L1m0n/night-lamp/docs/spec.md

# Приліжкова лампа — спека v1

Дата: 2026-11-01. Джерело форми: `Lamp-v0.0.2.step` — надрукований прототип 175 мм. (Перша версія спеки помилково брала `lamp-export-1.step`, 250 мм.)

## 1. Навіщо

Акумуляторна лампа на тумбочку: м'яке тепле світло перед сном, яке не будить партнера і яким легко керувати наосліп. Великий диск-дімер зверху: поворот змінює яскравість, увімкнення залежить від варіанта (див. §5). Усередині стоїть колона з адресною RGBW-стрічкою на ESP32. З телефона можна вибирати режими і пресети кольорів, а також створювати свої.

## 2. Що на виході цього етапу

1. `parts.html` — таблиця комплектуючих з чекбоксами «є / замовлено» (стан зберігається в браузері).
2. `parts-3d.html` — перегляд 3D кожної деталі окремо, з вибором деталі зі списку.
3. `render.html` — гарний рендер усієї лампи (світиться, можна крутити, є розібраний вигляд).
4. `schematic.html` — принципова схема, варіанти V1 / V2.
5. `wiring.html` — наочна схема підключень (хто куди паяється), V1 / V2.
6. `case/lamp.scad` — параметрична модель усіх друкованих деталей, і з неї STL.

**Стиль сторінок — «Папір»** (обрано з трьох варіантів): приємний, мінімалістичний.
- Тло теплий папір `#f7f4ee`, текст чорнило `#2b2722`, другорядний `#7b7266` / `#9a8f80`, лінії `#e4ddd1`.
- Один акцент — теракота `#c0643f` (позначені чекбокси, активний пункт, лінки).
- Заголовки — антиква Newsreader, текст — Inter, цифри й розміри — табличні цифри.
- Таблиці з тонкими горизонтальними лініями, без заливок і тіней; багато повітря.
- Темна тема — той самий характер на теплому темному тлі (`#1d1b18`, текст `#ece6dc`, акцент `#d9825e`).

**Не входить у цей етап:** прошивка ESP32 (буде наступним етапом, бо схема вже під неї розрахована) і креслення під фрезерування.

## 3. Форма і габарити (зі STEP)

| Тіло | Розміри |
|---|---|
| Шейдер | форма lamp-0.1.1 (`lamp-export-1.step`), зменшена ×0.7 від дна: дно-кільце r28…38.5, заокруглення R17.5, пояс Ø112 (висота 17.5–24.5 від дна), конус до Ø98 угорі, висота 164.6. Нижче шва — бетонна основа зі стінкою 5 мм, плафон 1.2 (2 лінії по 0.6). Угорі пластина 2 мм з отвором Ø20 і заглибленням Ø94.5 під дімер |
| Дімер | диск Ø93 × 2.5, знизу хвостовик Ø18 × 10 |
| Бетонна основа | одна відливка від столу (z=5) до шва (z≈48.2): зовні форма шейдера нижче шва, стінка 5 мм, порожнина з ухилом 1° до відкритого верху; на дні кишеня під IP5306 з виходом USB-C в бік +X і канал Ø8 вгору; 4 ребра 9.2×7 мм (0/90/180/270°) із замурованими латунними вставками M3×5.7 |
| Байонетне кільце | PETG, лягає в край основи зсередини, 4 гвинти M3×6 з потайною головкою в ребра; 4 Г-пази, поворот 30°. **Друкується перевернутим** (верхнім торцем на стіл): у робочому положенні його низ висить над столом на 2.4 мм через вушка; перевернуте — лише 4 малі містки ~50 мм² над головками гвинтів |
| Принтер | Bambu A1 mini, 180 × 180 × 180: найвища деталь — плафон, 137 мм; друкується догори дриґом (пластиною на стіл), підтримка в заглибленні під дімер і під пласкою полицею над манжетою (кільце ~8 мм завширшки, стінка скрізь 1.2 мм) |

Мої зміни до форми:
- **Шейдер ріжеться трохи вище поясу** на **основу** (бетон) і **плафон**: край основи на 1 мм вищий за відбивач, тож акумулятори й плати повністю в непрозорій основі. Плафон знімається байонетом у кільці.
- **Габарит після змін:** Ø112 × ~175 мм від столу (164.6 шейдер + 10 підйом) — як надрукований прототип.
- **Лампа піднята на 10 мм** над столом (було 5): під основою вміщається штекер USB-C.
- **USB-C виходить у бік основи (+X).** Модуль IP5306 лежить у кишені на дні, гніздо дивиться назовні. Кишеню і канал під дроти вгору відливаємо з надрукованим вкладишем-сердечником `puck_core`.
- **Основа — одна бетонна відливка** (корпус і ніжка разом) у друкованій формі.

### Відливання основи

Деталі форми (`mold_outer_a/b`, `mold_core`, `usb_core`) збираються в `case/stl/mold/` і в 3D-перегляд не потрапляють.

1. Підготовка: змастити воском/мастилом усі поверхні форми і штирі, віск у різьбу латунних вставок, вставки надіти на штирі сердечника.
2. Складання: половини форми стягнути болтами M3 (фланці, нижня пара + 4), поставити `puck_core` і `usb_core` (кінчик у гнізді стінки).
3. Заливка: бетон до рівня краю, повільно опустити сердечник (канал `puck_core` входить у його гніздо), прикрутити бортик M3 до фланців форми, вібрувати.
4. Розпалубка: відкрутити сердечник і підняти вгору (штирі виходять з вставок); відкрутити болти й розвести половини вздовж ±Y; виштовхнути `puck_core` униз; витягти `usb_core` убік +X.
5. Після розпалубки збити стовпчики від випусків: рівно з поверхнею на дні порожнини (там сідає шасі) і на верхах ребер (там сідають вушка кільця).
6. Друк форми: зовнішні половини зовнішньою гранню вниз, плавником вгору.

## 4. Деталі, які я проєктую

| Деталь | Матеріал | Що робить |
|---|---|---|
| Плафон (верх шейдера) | PLA білий, напівпрозорий | розсіює світло; знизу 4 ламелі байонета; угорі пластина з отвором Ø20 |
| Основа (низ шейдера) | бетон, одна відливка (+ друкована форма і сердечник `puck_core`) | вага; кишеня під IP5306 і USB-C; 4 ребра з латунними вставками M3 |
| Байонетне кільце | PETG | 4 Г-пази під ламелі плафона, горбик-фіксатор; 4 гвинти M3×6 у ребра основи |
| Форма для відливки | PLA | `mold_outer_a/b`, `mold_core`, `usb_core`; болти M3 |
| Шасі | PLA | диск у краї основи (виїмки під ребра): 4 акумулятори двома стосами по 2 з боків колони, вертикальний паз під ESP32 за їх торцем, гніздо колони в центрі |
| Колона | PLA білий | восьмигранник, грань 12.5 мм; доходить до верхньої пластини плафона (зазор 0.5), тож між колоною і плафоном вільного місця немає. Стрічка 10 мм на 8 гранях (смуга z 42.8…142.8, 6 LED); на кожній грані отвір Ø3.5 під і над смугою; угорі всередині — вузол дімера з кнопкою на поличках, ребро не дає йому провертатися; хвостовик дімера заходить у колону зверху |
| Вузол дімера V1 | PLA | гільза в колоні + каретка з потенціометром B100K, під нею кнопка KFC-003A, хід 0.4 мм |
| Вузол дімера V2 | PLA | гільза в колоні, на верхню стінку якої RK097NS кріпиться гайкою |
| Дімер | PLA/PETG пастельний | диск зі STEP; отвір у хвостовику під рифлений вал 6 мм |

## 5. Електроніка

**Живлення.** 4 × Li-Pol 850 мА·год (60×20×8 з PCM і скотчем, заміряно) **паралельно** (1S, ≈3400 мА·год) → IP5306 (заряджання через USB-C ~2 А, повна зарядка ≈2 год) → 5 В OUT → ESP32-C3 SuperMini (вхід 5V, LDO на платі) і стрічка. ESP32 від акумулятора напряму **не** живиться.

**Стрічка.** SK6812 RGBW 5 В, 60 LED/м (LT SMART, біла плата). 8 смуг по 6 LED = **48 LED** (~0.8 м). Смуги йдуть змійкою, шини 5 В/GND проходять усередині колони; дроти кожної смуги заходять у колону через отвір біля її DIN-кінця. У прошивці струм обмежено до 1.5 А (≈7.5 Вт), бо IP5306 дає максимум 2.1 А.

**Сигнал.** GPIO10 → 330 Ом → DIN, резистор впаяний у дріт біля стрічки. Зсуву рівня немає: 3.3 В нижче за поріг SK6812 (3.5 В), але зазвичай працює. Якщо стрічка мерехтить — перший світлодіод живиться через діод 1N4148 (поріг падає до ≈3 В).

**Потенціометр.** Крайні виводи на 3V3/GND, повзунок → GPIO0 (АЦП). Напруга батареї: дільник 220k/220k → GPIO1, щоб показувати заряд у веб-інтерфейсі; резистори паяються прямо на піни ESP32. Шум АЦП прибирає прошивка усередненням.

| | **V1 — твій B100K** | **V2 — RK097NS 10K з вимикачем (є, обрано)** |
|---|---|---|
| Увімкнути | натиснути дімер: каретка тисне KFC-003A → KEY на IP5306 → з'являються 5 В → ESP32 стартує | повернути зі «клацом» |
| Вимкнути | два натискання дімера за секунду — IP5306 вимикає 5 В сам. Ручка на мінімумі лише гасить світло | «клац» розриває 5 В між IP5306 і навантаженням |
| Нюанс | якщо забути вимкнути, ESP32 і погашена стрічка тягнуть ~0.1–0.15 А, акумулятор сяде за ≈ 15–20 год | IP5306 має сам прокинутись, коли знову з'являється навантаження (перевіряється на столі) |

Плати-перехідника немає: усе з'єднується дротами між модулями. R1 — у дроті DIN, R2/R3 — на пінах ESP32, кнопка V1 — прямо на KEY і GND IP5306.

**Керування з телефона (під прошивку).** Wi-Fi: точка доступу «Lamp» плюс за бажання домашня мережа, адреса `lamp.local`. Режими: теплий білий, нічник (бурштиновий, дуже тьмяний), колір, свічка, дихання, «захід сонця» з таймером вимкнення. Пресети зберігаються у флеш-пам'яті. Яскравість задає ручка.

## 6. Обмеження

- Друк FDM, стінки 2 мм (плафон 1.2), зазори 0.2–0.3 мм.
- Акумулятори перед паралельним з'єднанням вирівнюються за напругою (±0.05 В). У кожної комірки свій захист (PCM). Без захисту не з'єднувати.
- Плафон напівпрозорий, тому шасі зверху закрите білим диском-відбивачем, щоб тіні від плат не проступали.

## 7. Мої рішення (перевір)

- Восьмигранна колона і 48 LED (на грань влазить лише 6). Тіні від граней на плафоні не видно.
- ESP32 стоїть вертикально в пазу за торцем акумуляторів: лежачи вона не влазить в основу Ø112.
- Байонет, а не різьба: його простіше друкувати, і поворот лише на 30°.
- 4 акумулятори двома стосами по 2 з боків колони: 6 при стінці основи 5 мм і нинішньому шві не влазять. «Вітряк» і комірки на ребрі в торцях у Ø112 не влазять.
- Основа — бетонна відливка, а не друкована чаша: вага, і байонет не сидить у стінці 2 мм, а винесений в окреме змінне кільце на гвинтах.
- Без плати-перехідника і без зсуву рівня: три резистори в дротах. Запасний план від мерехтіння — діод 1N4148.
- Сторінки локальні; за бажання опублікую їх як посилання.

## 8. Налаштувати після пробного друку

У `case/lamp.scad` ці параметри номінальні, їх підбирають за першим друком кільця і плафона:
- `bump_sq` (0.15 мм) — стиск ламелі на горбику-фіксаторі: клацає надто слабо, збільшити; не проходить, зменшити;
- `bay_pre` (0.05 мм) — натяг у замкненому положенні: плафон люфтить, збільшити; не провертається, зменшити;
- `ring_fit` (0.3 мм) — радіальний зазор кільця й вушок до бетону: не лягає в основу, збільшити; за потреби підшліфувати зовнішню грань кільця.

Кільце й посадку плафона зручно перевірити ще до відливки, на пробній чаші з пластику: `case/stl/test/base_plastic.stl` (`part="base_plastic"`). Це та сама основа, але отвори під латунні вставки M3 мають Ø4,0 (`insert_heat_d`) і на 1 мм глибші: вставки вплавляють паяльником. Друкувати ніжкою на столі, з підтримкою лише від столу (`On build plate only`).

## 9. Лишається на складання

Точні заміри модулів, які вже на руках (IP5306, плата ESP32, вал RK097NS). У `.scad` вони винесені параметрами з позначкою «заміряти».
