L1m0n/night-lamp/docs/superpowers/specs/2026-11-05-concrete-base-design.md

# Бетонна основа і байонетне кільце — дизайн

Дата: 2026-11-05. Доповнює `docs/spec.md`. Стосується лише нижньої частини лампи і кріплення плафона.

## Навіщо

Друкована чаша з байонетом прямо в її стінці 2 мм не подобається. Основа має стати бетонною, однією відливкою. Плафон має триматися міцно, але бути розбірним і ремонтопридатним.

## Що вирішено (рішення користувача)

- **Чаша і шайба — одна бетонна відливка.** Стінка чаші 5 мм.
- **Плафон не змінюється:** та сама форма, шов на тій самій висоті (`cut_z` = 48.2), стінка 1.2 мм. Змінюється тільки кріплення на його манжеті.
- **Кріплення — байонет в окремому кільці.** Кільце друкується (PETG), лягає всередину краю бетонної чаші і пригвинчується до бетону гвинтами M3 у латунні вставки, які замуровуються при відливці. Гвинти видно лише при знятому плафоні.
- **Акумулятори: 4 комірки 60×20×8** (два стоси по 2), ≈3400 мА·год. 6 комірок при стінці 5 мм і нинішньому шві не влазять.

## Розглянуті підходи

| Підхід | Чому ні / так |
|---|---|
| Посадка з гумовим кільцем | не тримає міцно: плафон зіскакує, якщо підняти лампу за нього |
| Магніти в бетоні й манжеті | користувачу не сподобалось; точне закладання магнітів у форму |
| Різьба, замурована в бетон | не ремонтопридатна: кільце в бетоні не замінити |
| 3 гвинти збоку через бетон | головки гвинтів на виду |
| Стяжка знизу через колону | конфлікт із вузлом дімера в колоні |
| **Байонетне кільце на гвинтах** (обрано) | міцно, без люфту; знімається поворотом; зношувані частини — кільце й ламелі — друковані й змінні; у бетоні нічого не ламається |

## Як влаштовано

### Бетонна основа (`base`)
- Одна відливка від столу (z=5) до краю чаші (`cut_z`). Зовні — нинішня форма шейдера нижче шва (кільце-дно, заокруглення, пояс, низ конуса), плюс те, що зараз робить шайба знизу.
- **Стінка 5 мм.** Внутрішня порожнина — **з ухилом ≥1° до відкритого верху**, щоб сердечник форми виймався вгору. Зараз внутрішня поверхня над поясом звужується до краю (r 51 → 50.6), а це піднутрення 0.4 мм: жорсткий сердечник застряг би. Тому порожнина = конус з ухилом, обрізаний зміщенням зовнішньої форми на 5 мм. Нижче поясу стінка вийде трохи товща за 5 мм — це нормально.
- **Дно** — колишня шайба: кишеня під IP5306 з виходом USB-C в бік, канал Ø8 під дроти вгору (зараз `puck_void()`). Відливаються вкладишами-сердечниками, як і планувалось для шайби.
- **Чотири латунні вставки M3** (вплавні/вклеювані, knurled) у бетонних п'ятачках під кільцем — на 0°, 90°, 180°, 270°. На цих кутах немає кутів акумуляторів (вони на ~±52°, ±128°) і немає ESP32 (−X — перевірити зазор). П'ятачки — місцеві потовщення стінки, а не суцільний уступ, щоб не відбирати місце в акумуляторів.

### Байонетне кільце (`bay_ring`, PETG)
- Висота ~6 мм, товщина ~2.5 мм, лягає в бетон зсередини одразу під краєм; зверху врівень з краєм чаші.
- 4 внутрішні вушка з отворами під гвинти M3 з потайною головкою, на п'ятачки зі вставками.
- **4 Г-пази зі скосом (як у кришки банки):** вертикальний вхід, потім поворот на ~30°, під час якого ламель іде по пологому підйому і притягує плафон до краю чаші. У кінці — горбик-фіксатор, ламель його перескакує з клацом.

### Плафон (`shade_top`)
- Манжета стає під кільце: зовнішній радіус ≈ внутрішній радіус кільця мінус зазор; товщина манжети лишається 1.6.
- **4 ламелі** замість 3, ширші (≈10 мм по дузі), верхня грань — під скос пазу.
- Скіс 45° між стінкою плафона і манжетою лишається (тепер він вищий, бо манжета вужча), щоб плафон і далі друкувався догори дриґом без високих підтримок.
- Стінка, форма і шов — без змін.

### Що всередині
- **Шасі** (друковане) лежить на бетонному дні порожнини. 4 комірки двома стосами по 2 з боків колони, ESP32 ребром за їх торцем (−X), як зараз.
- **Висота стосів обмежена з обох боків:** знизу заокругленням дна (кут нижньої комірки, r ≈ 48.95, влазить при стінці 5 мм лише з z ≈ 26), зверху — кільцем (вище його низу на r ≈ 48 акумуляторів бути не може). Вікно ≈ z 26…42.2 при кільці 6 мм — для 2 шарів по 8 мм впритул. Це найтісніше місце дизайну; asserts мають його ловити.
- **Відбивач** лежить над акумуляторами, всередині кільця/манжети (діаметр зменшується під внутрішній радіус манжети).
- Колона, дімер, стрічка, електроніка — без змін.

### Форма для відливки (друкується)
- Зовнішня оболонка з двох половин (рознім по осі), сердечник порожнини (виймається вгору завдяки ухилу), вкладиші під IP5306/USB-C і канал, 4 штирі-тримачі для латунних вставок.
- Генерується з того самого `lamp.scad` (частини `mold_*`), щоб завжди відповідати основі.

## Що змінюється в проєкті

- `case/lamp.scad`: нова деталь `base` замість `bowl` + `puck` (+ `puck_core`); `bay_ring`; частини форми `mold_*`; манжета й ламелі `shade_top`; `chassis` під 4 комірки і нове дно; `reflector` під менший діаметр; asserts на вікно акумуляторів, ухил порожнини, п'ятачки vs акумулятори/ESP32, кільце vs стінка, шов плафона.
- `tools/build.sh`, `assets/models.js`, `assets/lamp3d.js`: нові деталі в переліку, підписи.
- Сторінки: `parts.html` (Li-Pol ×4, латунні вставки M3 ×4, гвинти M3 ×4, PETG для кільця, бетон замість «бетонна шайба»), `render.html` (бетонна основа замість пастельної чаші: колір чаші → колір/текстура бетону; кришка дімера лишається з пікером), `parts-3d.html`, `wiring.html` (BT1 — 4 комірки), `assets/nets.js` (BT1 4 комірки), `docs/spec.md`.

## Не входить

- Інший шов, інша форма чи стінка плафона.
- Рецептура бетону і процес відливки (розпалубка, сушіння) — лише геометрія форми.
- Прошивка.

## Лишається на збирача (мої рішення, перевір)

- Точні розміри кільця (6×2.5 мм), зазори посадки (0.2–0.3 мм), висота скосу пазу (≈0.6 мм на 30°), висота горбика.
- Ухил порожнини 1° — мінімум; більший ухил, якщо вікно акумуляторів дозволяє.
- Розмір латунних вставок: M3 × 5.7 (OD 4.6) — стандартні для вплавлення.
- Якщо вікно акумуляторів не сходиться (ніде 2 шари не влазять із зазором ≥0.3), — повернутись до користувача, а не тихо зменшувати до 2 комірок.
