L1m0n/night-lamp/case/preview_section.png

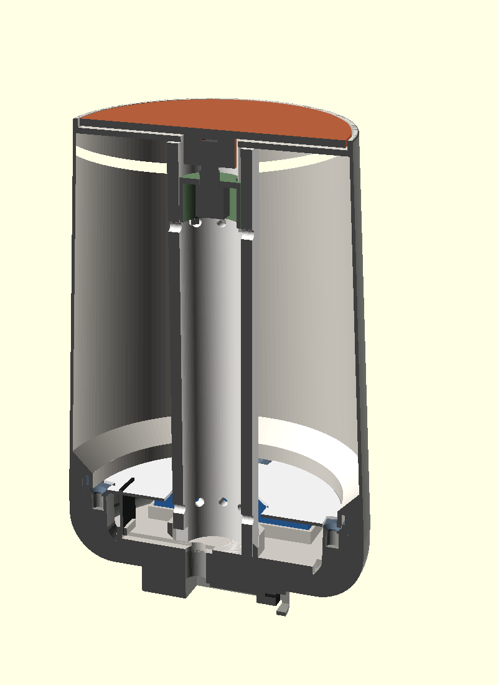
case/preview_section.png
