L1m0n/night-lamp/docs/shots/render-exploded.png

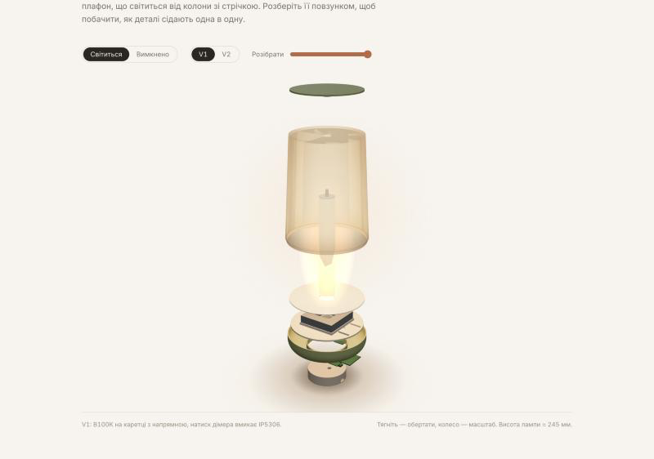
docs/shots/render-exploded.png
