L1m0n/night-lamp/docs/shots/render-on.png

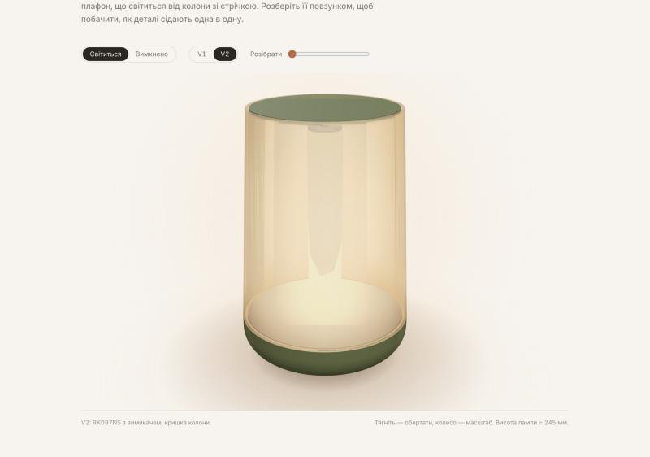
docs/shots/render-on.png
