L1m0n/night-lamp/docs/shots/schematic-v1.png

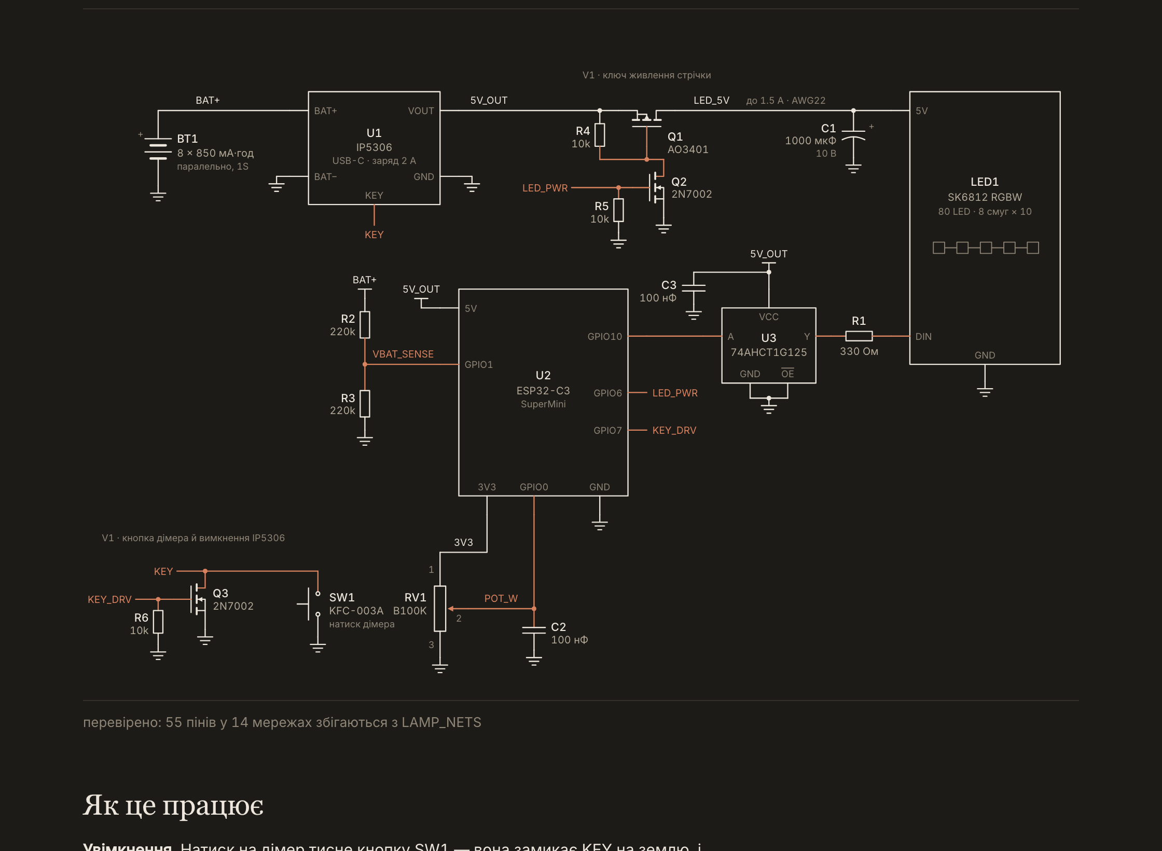
docs/shots/schematic-v1.png
