L1m0n/night-lamp/docs/shots/parts-3d.png

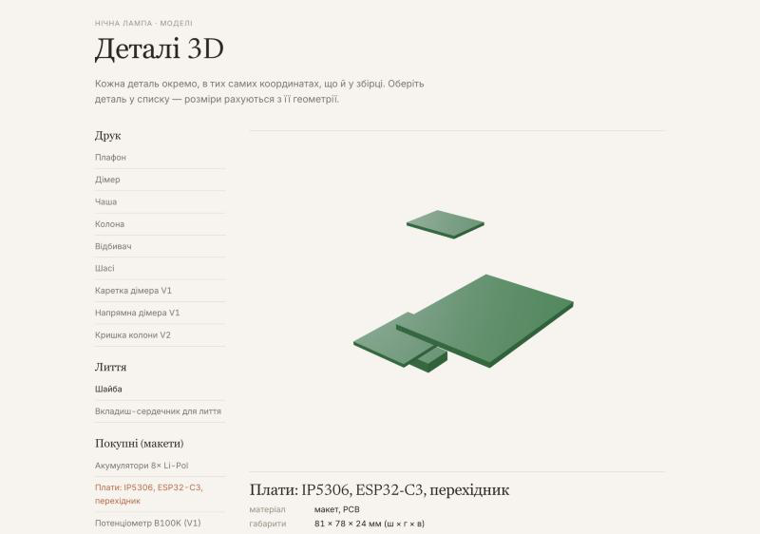
docs/shots/parts-3d.png
