L1m0n/night-lamp/case/stl/dimmer.stl

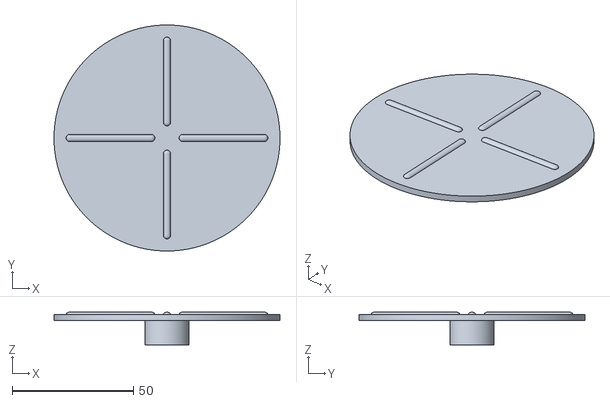
[picture p6: CAD file, 2026-11-11]
case/stl/dimmer.stl
93.1 x 93.1 x 13.5
