L1m0n/night-lamp/case/stl/mold/usb_core.stl

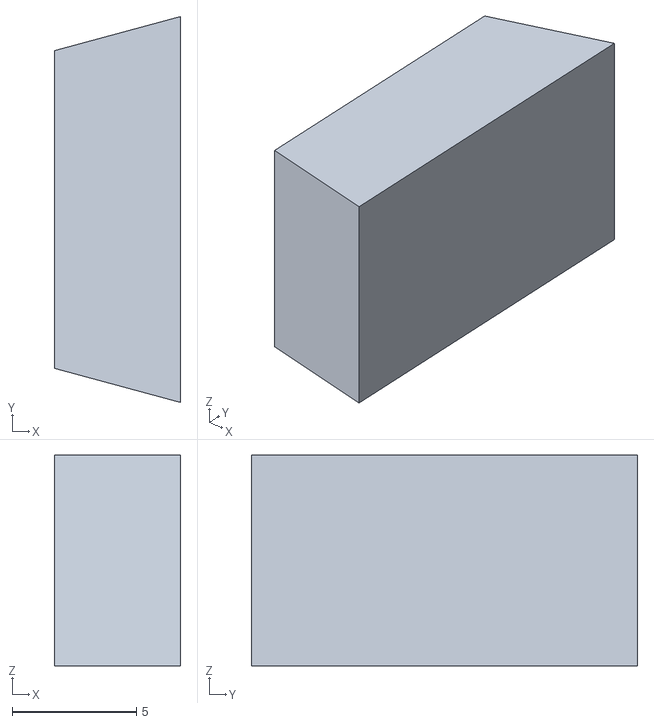
[picture p7: CAD file, 2026-11-06]
case/stl/mold/usb_core.stl
5.10 x 15.6 x 8.50
