L1m0n/night-lamp/case/stl/test/base_plastic.stl

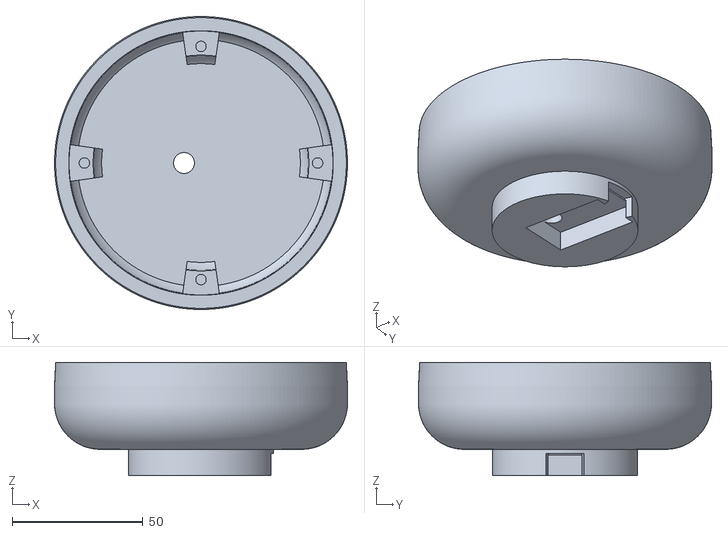
[picture p8: CAD file, 2026-11-06]
case/stl/test/base_plastic.stl
112.0 x 112.0 x 43.2
