L1m0n/night-lamp/case/stl/mold/mold_outer_b.stl

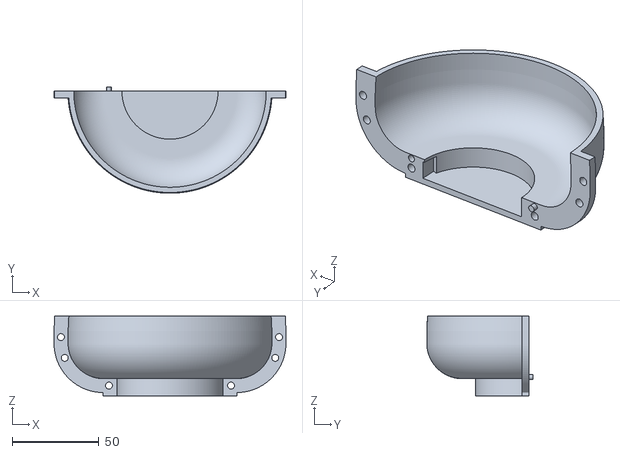
[picture p9: CAD file, 2026-11-06]
case/stl/mold/mold_outer_b.stl
134.0 x 61.5 x 46.2
