L1m0n/night-lamp/case/stl/pot_v2.stl

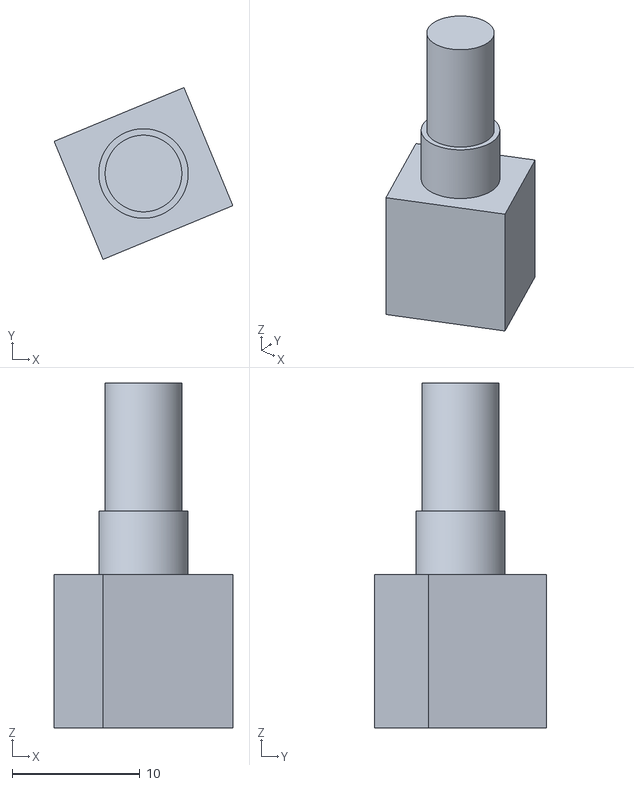
[picture p10: CAD file, 2026-11-11]
case/stl/pot_v2.stl
14.0 x 13.4 x 27.0
