L1m0n/night-lamp/case/stl/knob_v2_cap.3mf

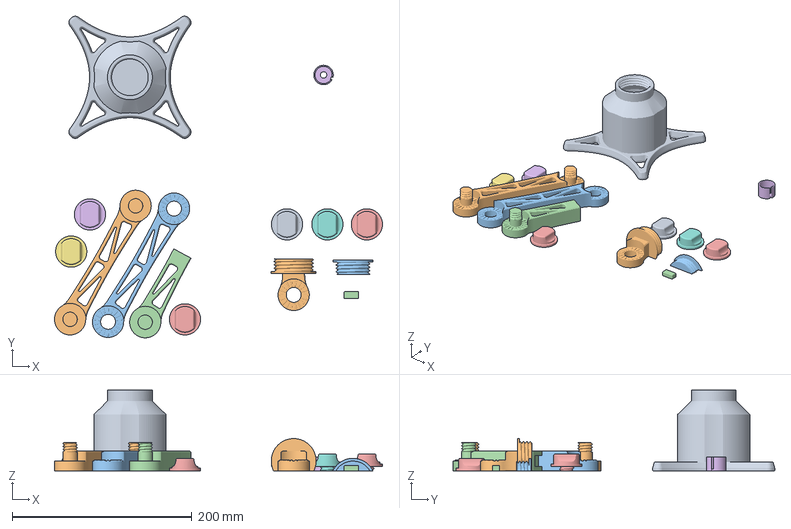
[picture p11: CAD file, 2026-11-11]
case/stl/knob_v2_cap.3mf
365.4 x 358.4 x 90.0 mm
Desk Light Stand - Heavy Light Base.stl
Desk Light Stand - Arm1.stl
Desk Light Stand - Arm2.stl
Desk Light Stand - Arm3.stl
Desk Light Stand - Nut.stl x 3
Desk Light Stand - Dummy Screw.stl x 3
Desk Light Stand - connector p1.stl
Desk Light Stand - connector p2.stl
Desk Light Stand - pin.stl
knob_v2_cap.stl
