L1m0n/night-lamp/case/stl/mold/mold_core.stl

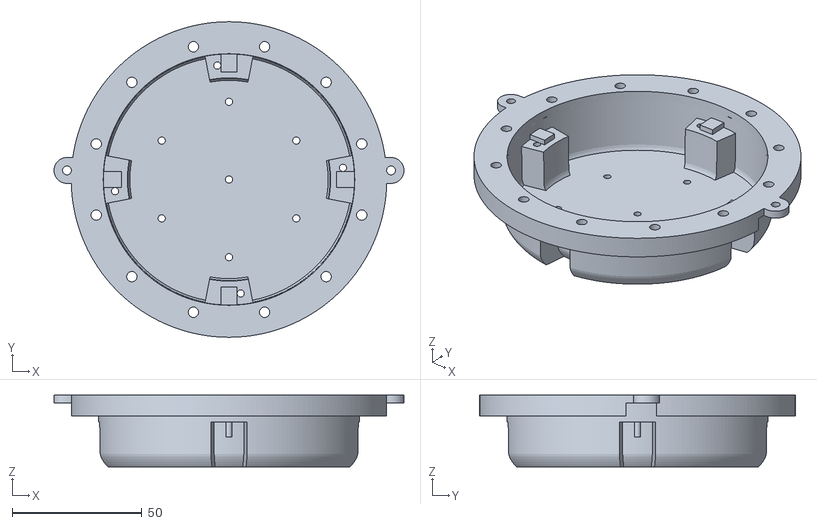
[picture p13: CAD file, 2026-11-05]
case/stl/mold/mold_core.stl
135.1 x 121.8 x 27.7
