L1m0n/night-lamp/case/stl/shade_top.stl

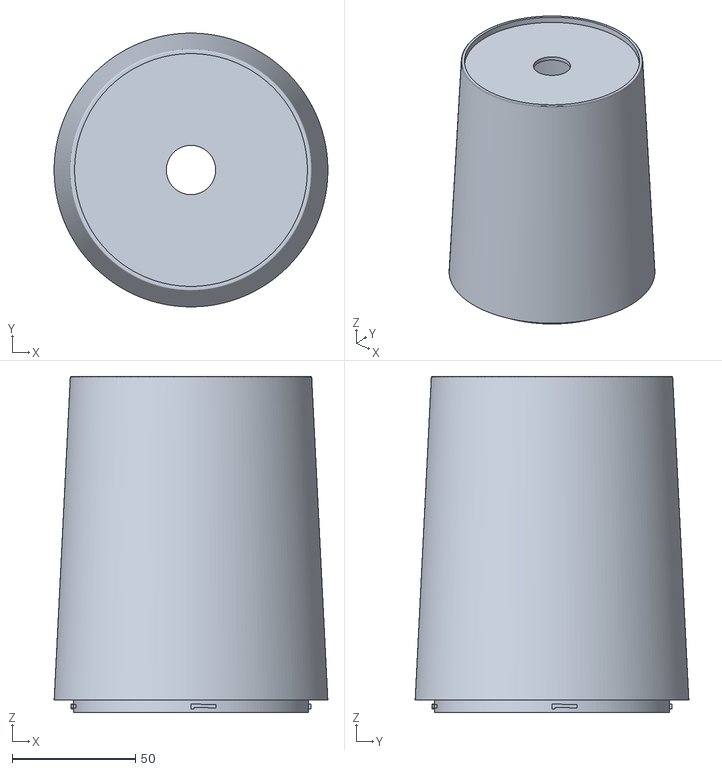
[picture p14: CAD file, 2026-11-07]
case/stl/shade_top.stl
111.1 x 111.1 x 136.4
