L1m0n/night-lamp/case/stl/bay_ring.stl

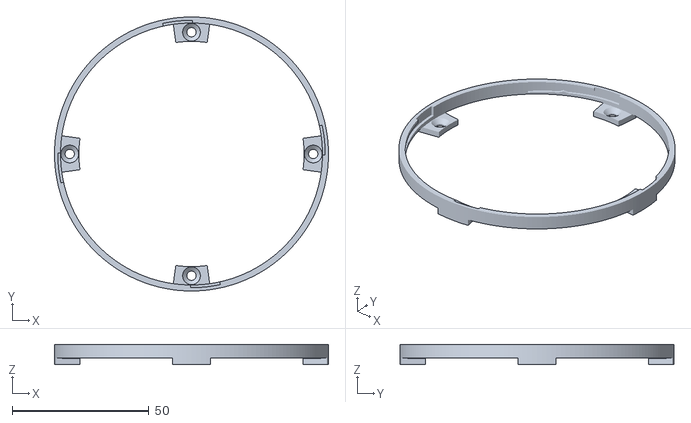
[picture p15: CAD file, 2026-11-06]
case/stl/bay_ring.stl
100.3 x 100.3 x 7.40
