L1m0n/night-lamp/case/stl/puck_core.stl

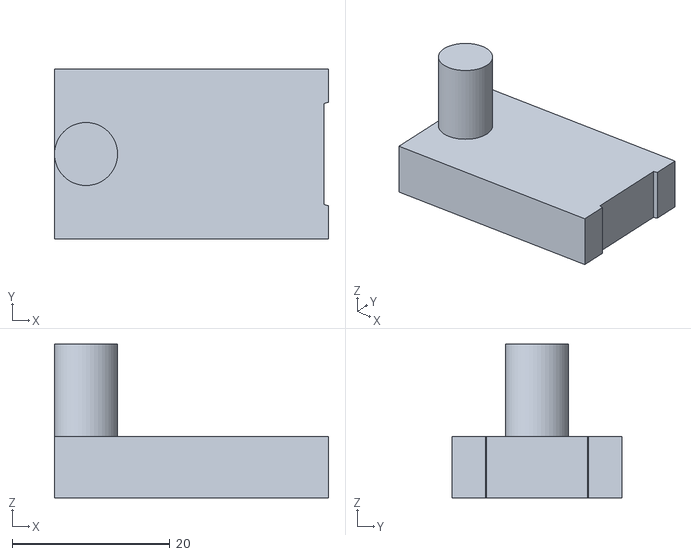
[picture p16: CAD file, 2026-11-06]
case/stl/puck_core.stl
34.8 x 21.6 x 19.5
