L1m0n/night-lamp/case/stl/chassis.stl

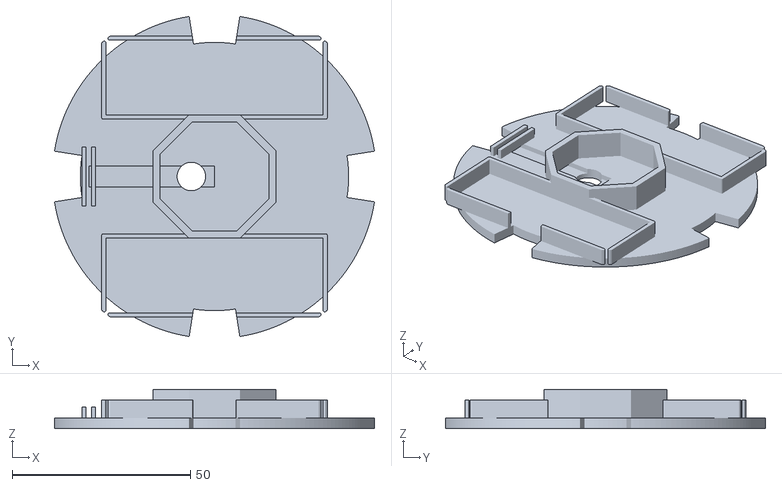
[picture p17: CAD file, 2026-11-06]
case/stl/chassis.stl
89.9 x 89.9 x 11.0
