L1m0n/night-lamp/case/stl/reflector.stl

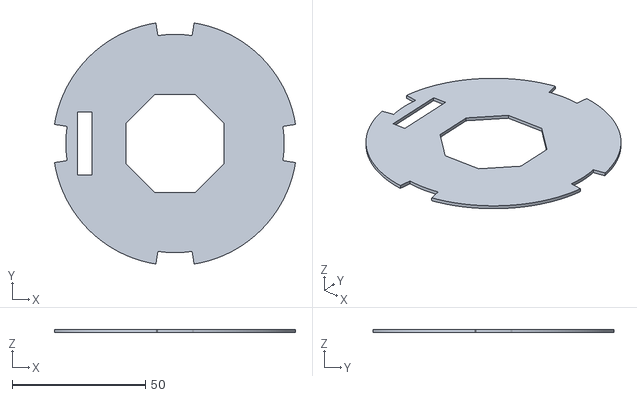
[picture p18: CAD file, 2026-11-05]
case/stl/reflector.stl
90.4 x 90.4 x 1.20
