L1m0n/night-lamp/case/stl/pcb.stl

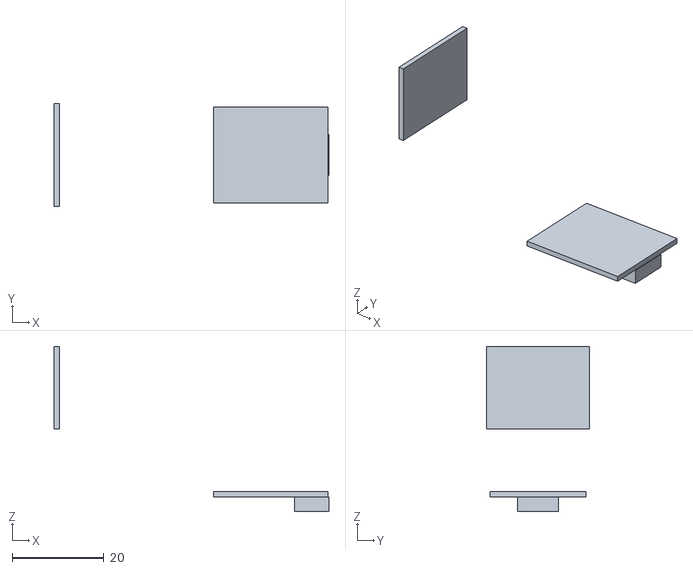
[picture p19: CAD file, 2026-11-05]
case/stl/pcb.stl
60.1 x 22.5 x 36.1
