L1m0n/night-lamp/case/stl/column.stl

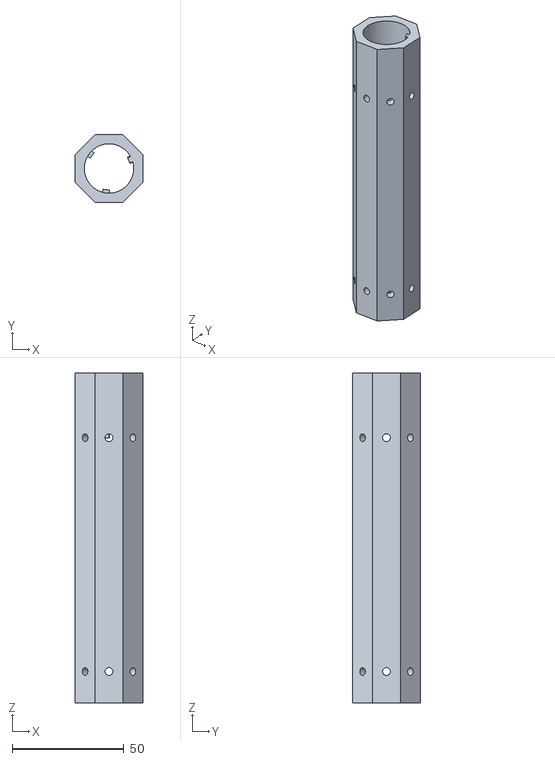
[picture p20: CAD file, 2026-11-05]
case/stl/column.stl
30.2 x 30.2 x 147.4
