L1m0n/night-lamp/case/stl/batteries.stl

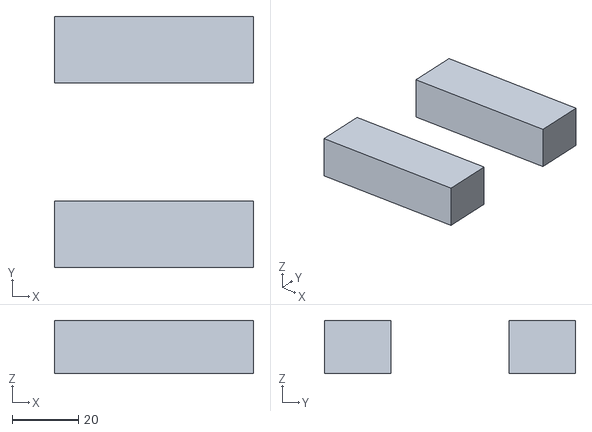
[picture p21: CAD file, 2026-11-05]
case/stl/batteries.stl
60.0 x 75.6 x 16.0
