L1m0n/night-lamp/case/stl/knob_v1_guide.stl

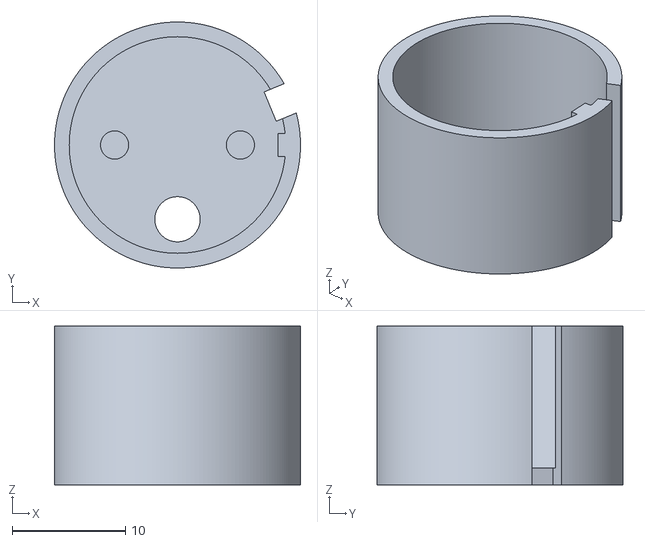
[picture p22: CAD file, 2026-11-01]
case/stl/knob_v1_guide.stl
21.7 x 21.7 x 14.0
