L1m0n/night-lamp/case/stl/knob_v1_carriage.stl

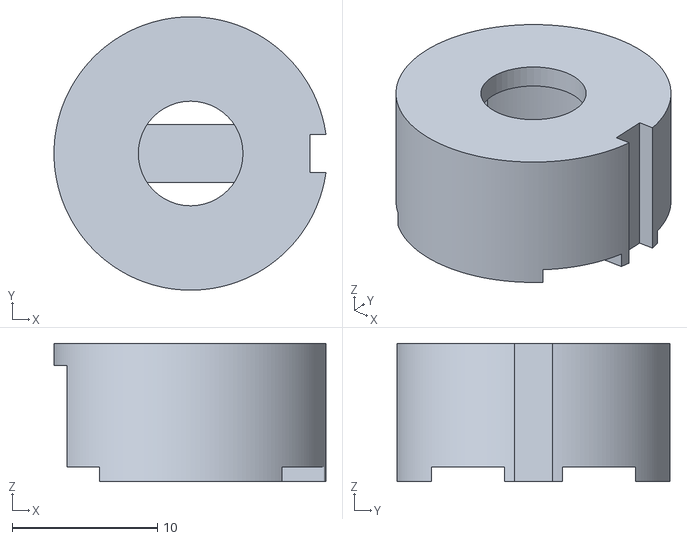
[picture p23: CAD file, 2026-11-01]
case/stl/knob_v1_carriage.stl
18.7 x 18.8 x 9.50
