L1m0n/night-lamp/(list of files, cad)

Other CAD files:
case/stl/base.stl
case/stl/knob_v2_cap.stl
case/stl/pot_v1.stl
