L1m0n/night-lamp/case/preview_assembly.png

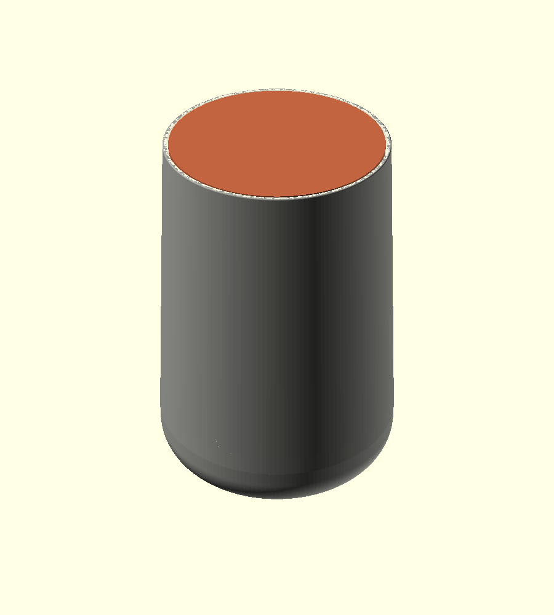
case/preview_assembly.png
