L1m0n/night-lamp/docs/shots/wiring-v1.png

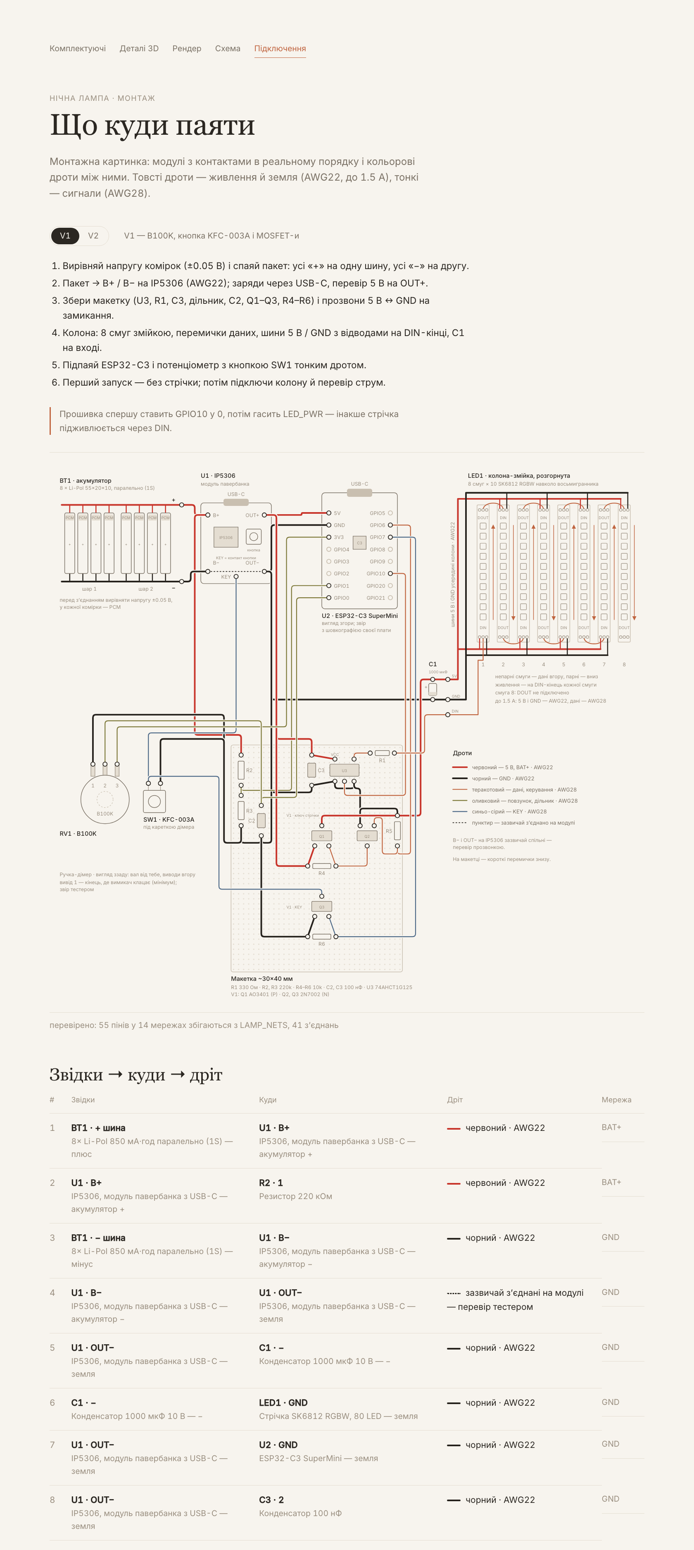
docs/shots/wiring-v1.png
