L1m0n/night-lamp/(commit log)

2026-11-01 case: parametric lamp model, STL build script and previews
    [batteries.stl, bowl.stl, chassis.stl, column.stl, dimmer.stl, knob_v1_carriage.stl, knob_v1_guide.stl, knob_v2_cap.stl]
2026-11-01 case: drop unused lamp parameters
    [lamp.scad]
2026-11-01 case: fuse shade_top sleeve, keep IP5306 pocket inside puck, puck fit
    [knob_v1_carriage.stl, knob_v1_guide.stl, lamp.scad, pcb.stl, pot_v1.stl, puck.stl, puck_core.stl, shade_top.stl]
2026-11-01 case: explicit USB-C plug countersink in puck with fit asserts
    [lamp.scad, puck.stl, puck_core.stl]
2026-11-01 Pack STL models into assets/models.js
2026-11-01 3d: per-part viewer and glowing lamp render (three r147)
    parts-3d.html lists parts by group, frames the chosen one with name,
    material, bbox size and how it is made; render.html shows the whole lamp
    with warm glow, V1/V2, exploded slider and a soft contact shadow.
    Shared loading, creased normals and materials live in assets/lamp3d.js.
2026-11-01 3d: frosted shade shows glowing column; render on demand
    Shade shells are translucent (front 0.62-0.68, back 0.40-0.45) with a soft
    additive core glow on the column and a steeper centre-to-edge falloff, so
    the column reads through the plafond lit and as a faint silhouette off.
    Both pages now render only when the camera, size or an animation changes.
    Re-took render-on.png, added render-exploded.png.
2026-11-01 schematic: single-source netlist and hand-drawn schematic page
    assets/nets.js holds window.LAMP_NETS (parts + nets per variant); nets that
    differ between V1 and V2 are stored as two complete copies so each name and
    pin appears once per variant. schematic.html draws the circuit as inline SVG
    in Paper tokens, hides the other variant's nodes, lists the nets and checks
    data-pin on the drawing against LAMP_NETS in both directions.
    parts.html: 2N7002 x2, 10k x3, C3 decoupling note.
2026-11-01 wiring: physical assembly view generated from LAMP_NETS
    wiring.html draws modules with pads in real order (IP5306, ESP32-C3
    SuperMini, perfboard, battery pack, pot/switch per variant, unrolled
    8-strip LED snake with DIN->DOUT arrows, data jumpers and 5V/GND buses).
    Wires are routed per net from LAMP_NETS in colour-coded harness lanes;
    the from->to->wire table is generated from the same chains. data-pin
    self-check runs both ways for V1/V2; variant is remembered in
    localStorage. --danger moved into paper.css.
2026-11-01 pot polarity: pin 1 = GND, pin 3 = 3V3 (CW brighter)
    nets.js: 3V3 -> RV1.3/RV2.3, GND -> RV1.1/RV2.1 in both variants.
    schematic.html: pot lead data-pin and pin numbers swapped to match.
    wiring.html: GND/3V3 chains and lanes rerouted to the new pins, SW1
    GND taken from R3.2, neutral pin-1 note, B-/OUT- join marked as
    'usually joined on the module, check with a tester'. Light screenshot
    including the table.
    [nets.js]
2026-11-01 case: wire holes on every column face around an explicit strip span
    Strip span is now a parameter (strip_z0=46, 10 LED @ 60/m). Each of the
    8 faces gets a 3.5 mm hole just below and above it; the reflector hole
    clears the strip. Asserts keep holes off the strip, above the chassis
    cup and below the dimmer node.
    [column.stl, lamp.scad, reflector.stl]
2026-11-01 pages: SOT-23 pinout, C4 ADC filter, shared variant, review fixes
    - Q1/Q3 G and S in real SOT-23 order, pin numbers on all SOT parts
    - C4 100 nF on GPIO1 in nets, schematic, wiring and BOM
    - schematic/render/parts follow lamp-variant (default V1)
    - column wiring text matches the new holes; pot note per variant
    - 32 s fallback wording, firmware GPIO10 order, bench checks, BOM fixes
    [nets.js]
2026-11-01 electronics: drop perfboard, level shifter, MOSFETs and filter caps
    V1 turns off by double-pressing the dimmer (IP5306 native), so the strip
    switch and KEY driver are gone. R1 sits in the DIN wire, the R2/R3 divider
    on the ESP32 pins; 1N4148 diode trick is the fallback if the strip flickers.
    Chassis loses the perfboard rails; the wire groove now runs to the ESP32.
    [chassis.stl, column.stl, lamp.scad, pcb.stl]
2026-11-01 case: resize to the printed prototype (Lamp-v0.0.2, 175 mm shade)
    The model was built from lamp-export-1 (250 mm), which does not fit a
    Bambu A1 mini. Shade now follows the prototype profile (Ø123 rib, 175 tall),
    split on the rib; tallest part is the top at 144 mm. Pocket wall is trimmed
    to the bowl, ESP32 stands upright in a slot, strip is 8 × 6 = 48 LEDs.
    [bowl.stl, chassis.stl, column.stl, dimmer.stl, knob_v1_carriage.stl, knob_v1_guide.stl, knob_v2_cap.stl, lamp.scad]
2026-11-01 case: keep the lamp-0.1.1 shape, scaled ×0.7 to the printed 175 mm
    Reverts the prototype-profile shade. Shade is lamp-export-1 scaled 0.7 from
    its base (wall stays 2 mm, 10 mm lift kept for the USB-C plug). Interior
    re-laid out for Ø112: puck Ø56, 4 cells in two stacks beside the column,
    ESP32 upright behind them, 8 × 6 = 48 LEDs. Tallest part: top, 146 mm.
    [batteries.stl, bowl.stl, chassis.stl, column.stl, dimmer.stl, knob_v1_carriage.stl, knob_v1_guide.stl, knob_v2_cap.stl]
2026-11-01 case: raise the cut so the bowl rim sits 1 mm above the reflector
    [bowl.stl, lamp.scad, reflector.stl, shade_top.stl]
2026-11-01 case: column reaches the top plate; dimmer node sits inside it
    Column now ends 0.5 mm under the shade's top plate, so there is no gap
    above it. V1 guide and V2 holder are sleeves inside the bore, resting on
    three ledges and keyed by a rib; the dimmer boss enters the column top.
    [column.stl, knob_v1_guide.stl, knob_v2_cap.stl, lamp.scad]
2026-11-01 case: measured cells 60×20×8 — six cells in two stacks of three
    Reflector and bowl rim move up 4 mm for the third layer; outer shape unchanged.
    [batteries.stl, bowl.stl, chassis.stl, lamp.scad, pcb.stl, reflector.stl, shade_top.stl]
2026-11-02 render: колір чаші
2026-11-02 render: дімер того ж кольору, що й чаша
2026-11-02 render: темні кольори чаші як матовий PLA
2026-11-02 render: чорний PLA темніший
2026-11-02 render: плафон — менш прозорий матовий PLA
2026-11-04 плафон: скіс 45° над манжетою, щоб друкувати догори дриґом без дерев підтримки
    [lamp.scad, shade_top.stl]
2026-11-04 плафон: стінка 1.6 мм — швидший друк і більше світла
    [lamp.scad, shade_top.stl]
2026-11-04 плафон: стінка 1.2 мм (2 лінії по 0.6)
    [lamp.scad, shade_top.stl]
2026-11-05 дизайн: бетонна основа і байонетне кільце
2026-11-05 план: бетонна основа і байонетне кільце
2026-11-05 основа: бетонна відливка замість чаші й шайби
    [base.stl, lamp.scad, shade_top.stl]
2026-11-05 основа: стінка 5 мм по нормалі, ребра замість полиць, коментарі
    [base.stl, lamp.scad]
2026-11-05 основа: повернуто канал крізь дно, assert і коментар до перевірки стінки
    [base.stl, lamp.scad]
2026-11-05 шасі: 4 комірки на бетонному дні
    [base.stl, batteries.stl, chassis.stl, column.stl, lamp.scad, pcb.stl, reflector.stl]
2026-11-05 відбивач: радіус під стінку основи, виїмки під ребра; спрощено assert шасі
    [lamp.scad, reflector.stl]
2026-11-05 байонетне кільце на гвинтах, 4 ламелі на манжеті
    [base.stl, bay_ring.stl, lamp.scad, reflector.stl, shade_top.stl]
2026-11-05 вушка кільця 2.4 мм: запас під зенківкою ≥ 0.6
    [base.stl, bay_ring.stl, lamp.scad, reflector.stl]
2026-11-05 гвинти всередині отвору кільця, ребра 9.2 мм, горбик із похилими боками
    [base.stl, bay_ring.stl, chassis.stl, lamp.scad, reflector.stl, shade_top.stl]
2026-11-05 горбик-фіксатор: лише на останніх градусах, п'ятка ламелі, стиск 0.15
    [bay_ring.stl, lamp.scad, shade_top.stl]
2026-11-05 форма для відливки бетонної основи
    [lamp.scad, mold_core.stl, mold_outer_a.stl, mold_outer_b.stl, puck_core.stl]
2026-11-05 форма: стелі пазів, usb_core, випуски, вушка сердечника, болти й штирі стику
    [lamp.scad, mold_core.stl, mold_outer_a.stl, mold_outer_b.stl, puck_core.stl, usb_core.stl]
2026-11-05 форма: клин біля підніжжя ребер (сердечник не виймався), вставка бортика в половині A, перевірки
    [base.stl, lamp.scad, mold_core.stl, mold_outer_a.stl, mold_outer_b.stl]
2026-11-05 сторінки під бетонну основу: 3D, перелік деталей, схеми, спека, прев'ю
    [bowl.stl, puck.stl]
2026-11-05 фінальні правки: проріз відбивача під ESP32, гвинт M3×6, ring_fit, байонет, асерти, тексти
    [base.stl, bay_ring.stl, lamp.scad, mold_core.stl, pcb.stl, reflector.stl, shade_top.stl]
2026-11-06 схема: підпис акумулятора 4 × 850 мА·год
2026-11-06 знахідки print-check: зенківка USB-C радіальна й відкрита донизу, без тонких смужок у шасі, без неманіфолдних швів у кільці й плафоні, кільце друкувати перевернутим
    [base.stl, bay_ring.stl, chassis.stl, lamp.scad, mold_outer_a.stl, mold_outer_b.stl, puck_core.stl, shade_top.stl]
2026-11-06 пробна чаша з пластику: base_plastic з отворами Ø4,0 під вплавлення вставок M3
    [base_plastic.stl, lamp.scad]
2026-11-07 плафон: стінка 1.2 мм рівно до шва, пласка полиця над манжетою замість суцільного скосу (друкується з підтримкою)
    [lamp.scad, shade_top.stl]
2026-11-08 кришка дімера: 4 скруглені планки хрестом 3 × 1 мм під палець (відступ 5 мм від центру й краю)
    [dimmer.stl, lamp.scad]
2026-11-11 RK097 B10K з вимикачем: заміряні розміри (вал 6×15, втулка 5, корпус 10×11×12)
    [knob_v2_cap.3mf, lamp.scad, pot_v2.stl]
2026-11-11 гільза V2: прямокутне гніздо 10.3×11.3×3 мм під корпус RK097, щоб не провертався
    [knob_v2_cap.stl, lamp.scad]
2026-11-11 гільза V2: гніздо з 4 кутовими упорами, середини граней відкриті під ніжки RK097; повернуто на 22.5° від паза ключа
    [knob_v2_cap.stl, lamp.scad, pot_v2.stl]
2026-11-11 гільза V2: замість кутових упорів — стінка під грань без ніжок і 2 бокові напрямні на пів корпусу RK097, бік із ніжками відкритий
    [knob_v2_cap.stl, lamp.scad, pot_v2.stl]
2026-11-11 дімер: отвір під вал 6.0 мм без натягу — з 5.9 кришку не знімеш
    [dimmer.stl, lamp.scad]
2026-11-12 сторінки: V2 (RK097NS з вимикачем) за замовчуванням — схема, монтаж, рендер
